hronkrobotics/solar-square/3d/solar-square-case.step

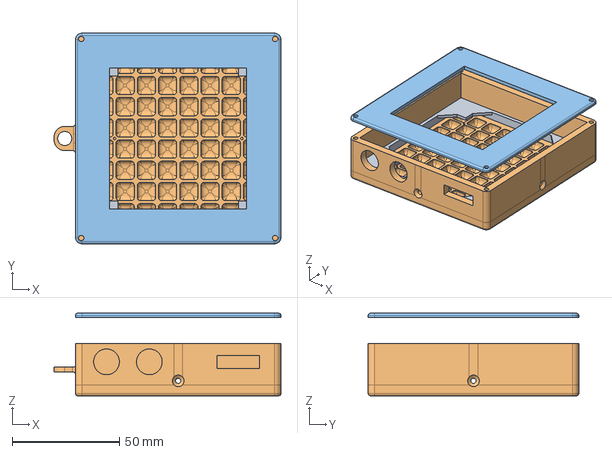
[picture p4: CAD file, 2026-11-03]
3d/solar-square-case.step
105.7 x 98.1 x 38.5 mm
LED BUTTON lid holder.step
LED BUTTON lid.step
