hronkrobotics/solar-square/(commit log)

2026-11-01 Add Solar Square v0.1: 8x8 WS2812B patterns, button controls, wiring and power notes
2026-11-02 Remove the button LED; the momentary button is wired without it
2026-11-03 Add phone control over Wi-Fi, the case STEP file, and an assembly guide
    [solar-square-case.step]
2026-11-03 Add build photos to the README
    Front, side, and back shots of the finished case, cropped to match
    the Solar Eyes image layout.
2026-11-03 Add the bracket screw size to the assembly guide
